nadernik/glass_udrive/BOM/BOM google sheet link.txt

https://docs.google.com/spreadsheets/d/1lBuhaIrTGy6_se6Jq8_9wrTlgxq24nmQ9v349KglLDg/edit?usp=sharing
