nadernik/glass_udrive/BOM/Glass uDrive-BOM.xlsx

Part on PCB | QTY | Value | Device | Package | Description | Use | SUPPLIER | partNo | link
U1 | 1 | AD8224ACPZ-R7 | AD8224 | QFN65P400X400X100-16N | IC OPAMP INSTR 1.5MHZ 16LFCSP-Hidden pad | Wide Supply Range, Rail-to-Rail Output Instrumentation Amplifier | Analog Devices | AD8224HBCPZ-R7CT-ND | https://www.digikey.com/short/jmmmcj
P1 | 1 | A75243-001 | A75243-001 | OMNETICS_A75243-001 |  | 14 pin nano, male | Omnetics | A75243-001
R_BRIDGE | 1 | 100MOhm | R_0402 | 402 | RES 100M OHM 5% 1/16W 0402 | Resistor for bridge balance circuit | Stackpole Electronics Inc | HMC0402JT100MCT-ND | https://www.digikey.com/product-detail/en/stackpole-electronics-inc/HMC0402JT100M/HMC0402JT100MCT-ND/2683714
C_COMP | 1 | 10pF | C_0402 | 402 | CAP CER 10PF 200V C0G/NP0 0402 | Capacitor for capacitance neutralization circuit | American Technical Ceramics | 1284-1096-1-ND | https://www.digikey.com/short/j4081m
C1-C4 | 4 | 6800pF | C_0201 | 201 | CAP CER 6800PF 16V X7R 0201 | Capacitor for high pass filter for electrodes and virtual ground (with R1-R4) | TDK Corporation | 445-12081-1-ND | http://www.digikey.com/short/38852m
C5-C6 | 2 | 0.1uF | C_0201 | 201 | CAP CER 0.1UF 25V X5R 0201 | Bypass capacitor for INA | Samsung Electro-Mechanics | 1276-1318-1-ND | https://www.digikey.com/short/jmmm1h
C7-C8 | 2 | 10uF | R_0603 | 603 | CAP CER 10UF 25V X5R 0603 | Bypass big capacitor for +-15 V supply for INA | Murata Electronics | 490-10991-2-ND | https://www.digikey.com/short/j403zm
R1-R4 | 4 | 10Mohm | R_0201 | 201 | RES SMD 10M OHM 5% 1/20W 0201 | Resistor for high pass filter for electrodes and virtual ground (with C1-C4) | Samsung Electro-Mechanics | 1276-3857-1-ND | https://www.digikey.com/short/jmm95b
R5-R6 | 1 | 5.49KOhm | R_0201 | 201 | RES SMD 5.49K OHM 1/20W 0201 | Gain setting resistor for INA (gain=10) | Panasonic Electronic | P121609CT-ND | https://www.digikey.com/short/j40jpz
SJ1 | 4 | 0 Ohm | R_0201 | 201
