nadernik/glass_udrive/eaglefiles/glass_udrive_pcb.dxf

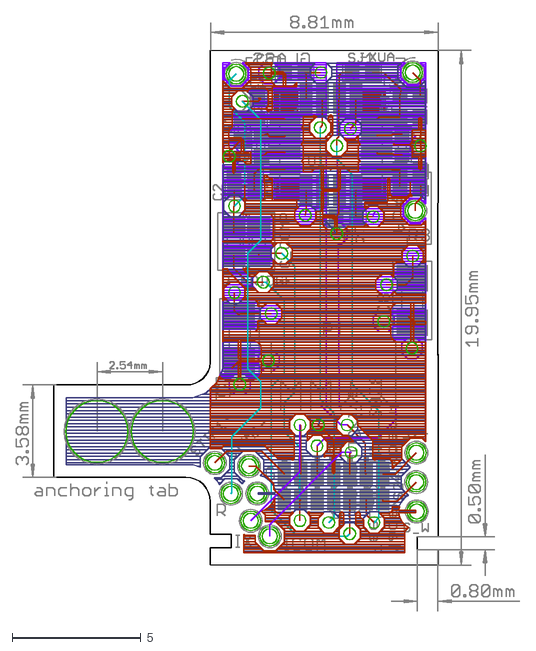
[picture p1: CAD file, 2018-05-21]
eaglefiles/glass_udrive_pcb.dxf
19.5 x 23.1
