nadernik/glass_udrive/layout_files/glass_udrive_pcb.dxf

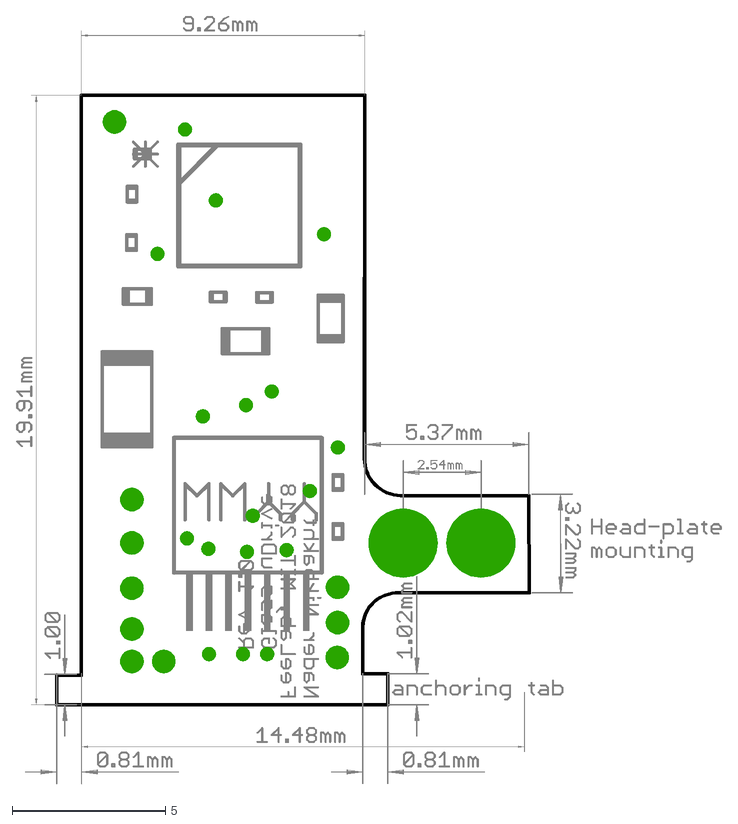
[picture p2: CAD file, 2018-05-07]
layout_files/glass_udrive_pcb.dxf
23.0 x 25.1
