nadernik/glass_udrive/eaglefiles/glass_udrive_pcb.brd

## EAGLE design eaglefiles/glass_udrive_pcb.brd (2018-05-24)

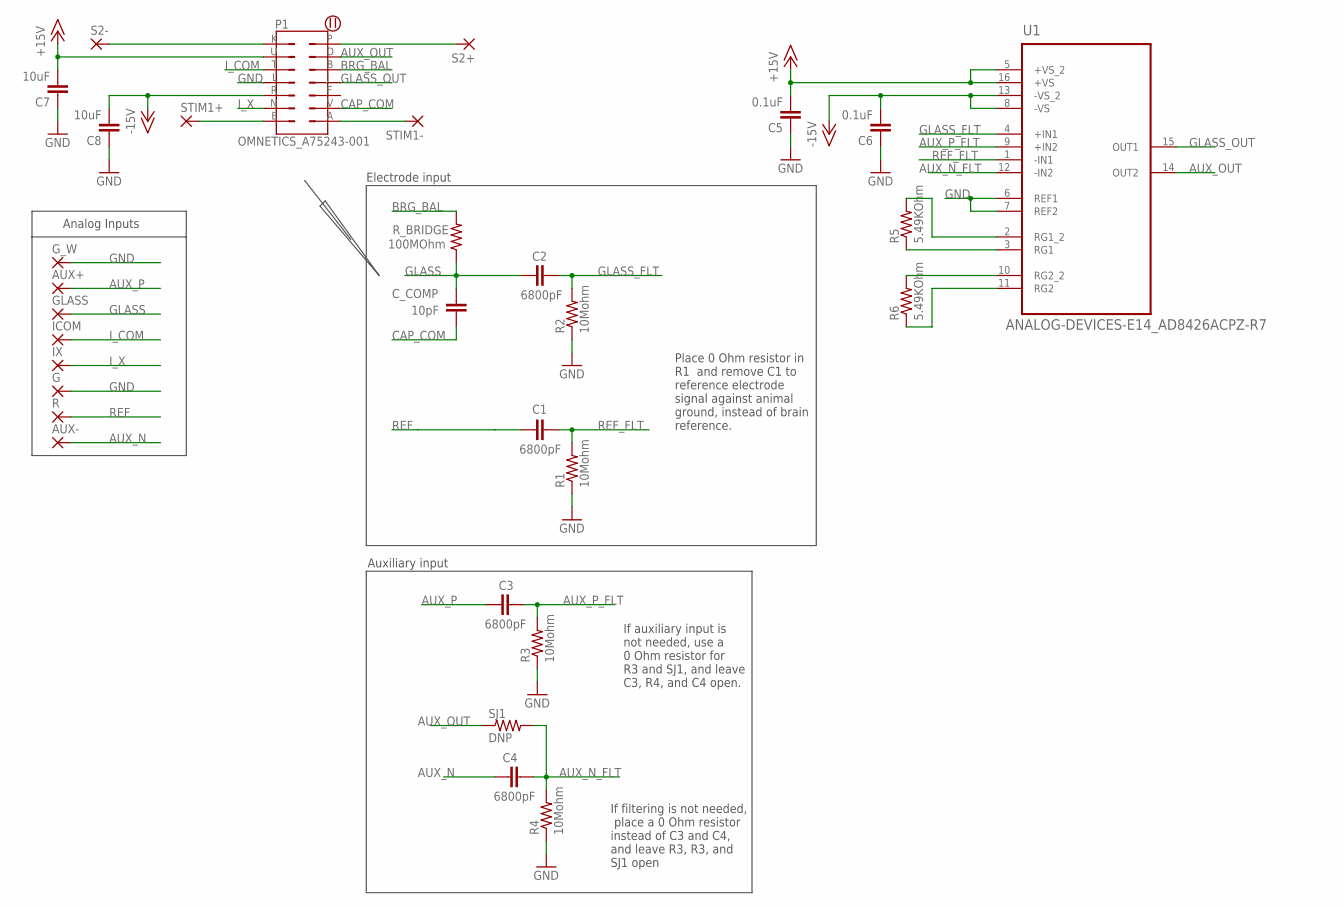
[picture p3: schematic glass_udrive_pcb.sch]

Parts:
AUX+: THROUGH-HOLE-30MIL/15MIL; 30MIL/15MIL
AUX-: THROUGH-HOLE-30MIL/15MIL; 30MIL/15MIL
C1, C2, C3, C4: 6800pF; 0201
C5, C6: 0.1uF; 0201
C7, C8: 10uF; 0603
C_COMP: 10pF; 0402
G: THROUGH-HOLE-30MIL/15MIL; 30MIL/15MIL
GLASS: THROUGH-HOLE-30MIL/15MIL; 30MIL/15MIL
G_W: THROUGH-HOLE-30MIL/15MIL; 30MIL/15MIL
ICOM: THROUGH-HOLE-30MIL/15MIL; 30MIL/15MIL
IX: THROUGH-HOLE-30MIL/15MIL; 30MIL/15MIL
P1: OMNETICS_A75243-001
R: THROUGH-HOLE-30MIL/15MIL; 30MIL/15MIL
R1, R2, R3, R4: 10Mohm; 0201
R5, R6: 5.49KOhm; 0201
R_BRIDGE: 100MOhm; 0402
S2+, S2-: THROUGH-HOLE-30MIL/15MIL; 30MIL/15MIL
SJ1: DNP; 0201
STIM1+, STIM1-: THROUGH-HOLE-30MIL/15MIL; 30MIL/15MIL
U1: ANALOG-DEVICES-E14_AD8426ACPZ-R7; ANALOG-DEVICES-E14_QFN65P400X400X100-16N

Connections:
+15V: C5.2, C7.2, P1.U, U1.5 (+VS_2), U1.16 (+VS)
-15V: C6.2, C8.2, P1.R, U1.8 (-VS), U1.13 (-VS_2)
AUX_N: AUX-.P$1, C4.1
AUX_N_FLT: C4.2, R4.2, SJ1.2, U1.12 (-IN2)
AUX_OUT: P1.D, SJ1.1, U1.14 (OUT2)
AUX_P: AUX+.P$1, C3.1
AUX_P_FLT: C3.2, R3.2, U1.9 (+IN2)
BRG_BAL: P1.B, R_BRIDGE.2
CAP_COM: C_COMP.2, P1.V
GLASS: C2.1, C_COMP.1, GLASS.P$1, R_BRIDGE.1
GLASS_FLT: C2.2, R2.2, U1.4 (+IN1)
GLASS_OUT: P1.J, U1.15 (OUT1)
GND: C5.1, C6.1, C7.1, C8.1, G.P$1, G_W.P$1, P1.L, R1.1, R2.1, R3.1, R4.1, U1.6 (REF1), U1.7 (REF2)
I_COM: ICOM.P$1, P1.T
I_X: IX.P$1, P1.N
unnamed: R5.2, U1.2 (RG1_2)
unnamed: R5.1, U1.3 (RG1)
unnamed: R6.2, U1.10 (RG2_2)
unnamed: R6.1, U1.11 (RG2)
REF: C1.1, R.P$1
REF_FLT: C1.2, R1.2, U1.1 (-IN1)
STIM1_N: P1.A, STIM1-.P$1
STIM1_P: P1.E, STIM1+.P$1
STIM2_N: P1.P, S2+.P$1
STIM2_P: P1.K, S2-.P$1

Notes on the sheet:
Analog Inputs
Electrode input
Auxiliary input
Place 0 Ohm resistor in R1 and remove C1 to reference electrode signal against animal ground, instead of brain reference.
If auxiliary input is not needed, use a 0 Ohm resistor for R3 and SJ1, and leave C3, R4, and C4 open.
If filtering is not needed, place a 0 Ohm resistor instead of C3 and C4, and leave R3, R3, and SJ1 open

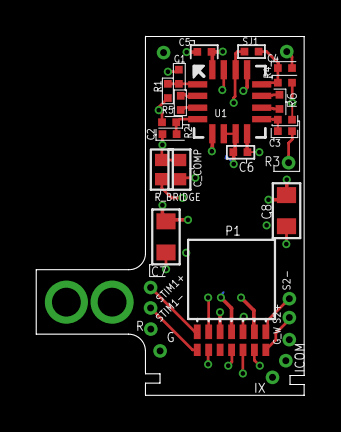
[picture p4: board glass_udrive_pcb.brd from above]

Board: 4 copper layers, 14.9 x 19.9 mm, 31 parts (0 on the bottom side), 25 nets.
