nadernik/glass_udrive/(commit log)

2018-04-24 :original commit adding PCB design files
    [glass_udrive_pcb.brd, glass_udrive_pcb.sch]
2018-04-24 smashed labels
    [glass_udrive_pcb.brd, glass_udrive_pcb.sch]
2018-04-25 Galen's suggested changes to Rev 1.0
    I have changed a number of things in your design, one of which is major and the
    rest are minor. The major change is that I have added a guard trace to your
    design, in accordance with the data sheet for the OPA129. If you are going to
    use an ultra-low input bias current op amp, then you should make efforts to
    actually achieve the performance that it touts. The other changes are mostly
    positioning to accommodate the guard trace, changes to the silk screen on your
    board, and simplification of the routing of some traces.
    To achieve very low input bias, you need to make sure that there is no leakage
    current to the electrode net from the rest of the PCB. There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
    [glass_udrive_pcb.brd, glass_udrive_pcb.sch]
2018-04-25 3D snapshots and Galen's edits merged.
    [glass_udrive_pcb.brd]
2018-04-30 added data sheets for AD8224
    [glass_udrive_pcb.brd]
2018-05-03 Revision AD8224 redesigned to use instrumentation amplifier with a reference electrode. This version has 2 input and 2 INA output channels one for glass electrode and another for a metal electrode.
    [BOM.xlsx, glass_udrive_pcb.brd, glass_udrive_pcb.sch]
2018-05-03 the modified version w/o output channel 2 and metal electrode input.
    [glass_udrive_pcb.brd, glass_udrive_pcb.sch]
2018-05-07 1-Incorporating Michael Stetner's comments: ====================================================== 1. Move vias carrying output signals away from the corners of the AD8224. According to the datasheet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
    [BOM.xlsx, glass_udrive_pcb.brd, glass_udrive_pcb.sch]
2018-05-07 extended drive length to give more space at the bottom for dental cement anchoring. PCB = 9.26mm X 19.91 mm
    [glass_udrive_pcb.brd]
2018-05-07 solved the order of CAPCOM and Bridge balance nets and routing as per GFL suggestions.
    [glass_udrive_pcb.brd, glass_udrive_pcb.sch]
2018-05-07 minor routing and dimension and docu layer changes.
    [glass_udrive_pcb.brd, glass_udrive_pcb.dxf]
2018-05-08 Move eagle design files into separate directory
    [glass_udrive_pcb.brd, glass_udrive_pcb.sch]
2018-05-08 Add gerbers dir to project, which should be empty
2018-05-08 Move layouyt files to their own directory
    [glass_udrive_pcb.dxf]
2018-05-08 Remove screenshots from repo
    These screen shots are 'derived' from the design files and should not be in the
    repository itself. For example, are they currently up to date, or do they
    reflect the design as it was a few commits ago? It's hard to tell, and therefore
    I think these sorts of files do more harm than good.
2018-05-09 Dev branches merged into master branch. Optimizing the board routing and incorporating GFL comments: =========================== 1- top right of AD8224 (pins 12 and 13): don't run a trace under the c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
    [glass_udrive_pcb.brd]
2018-05-10 updated several board layout details: made it smaller H and W, changed the anchoring tab on the opposite side, added +-15 power supply pours to simplify routing and reduced bridge resistor size to 40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
    [BOM.xlsx, glass_udrive_pcb.brd, glass_udrive_pcb.sch]
2018-05-11 Move bridge balance resistor up and trace from glass electrode to CAPCOM to layer 15
    [glass_udrive_pcb.brd]
2018-05-11 Added optional circuit for 2nd INA channel and routing optimized.
    [BOM.xlsx, glass_udrive_pcb.brd, glass_udrive_pcb.sch]
2018-05-13 simple routing finish-up and silk-screen stuff.
    [glass_udrive_pcb.brd]
2018-05-13 Went very OCD on your design
    Made the power planes bigger because they had no reason not to be.
    Renamed some nets because I found them confusing when looking at your schematic.
    Moved stuff for cleaner routing.
    Added a top ground plane to prevent stray capacitance onto any moving wires for
    your electrode etc.
    Improved via placement on bypass capacitors.
    Re-organized schematic to some degree.
    Renamed components to have more standard designator names, e.g. P1 instead of
    'omnetics' and U1 instead of "AD82**"
    Moved vias around to not make big breaks in the ground plane.
    Messed with dimensions so they're all rectilinear and meet up with eachother.
    [glass_udrive_pcb.brd, glass_udrive_pcb.sch]
2018-05-14 Made glass net more compact.
    Silk screen needs a lot of work
    [glass_udrive_pcb.brd, glass_udrive_pcb.sch]
2018-05-14 improvements on slikscreen and component naming and placing.
    [glass_udrive_pcb.brd, glass_udrive_pcb.sch]
2018-05-14 final touch by NN.
    [glass_udrive_pcb.brd]
2018-05-21 minor routing and dimention and docu layer improvements.
    [BOM.xlsx, glass_udrive_pcb.brd, glass_udrive_pcb.dxf]
2018-05-23 gerber files generated.
    [Glass uDrive-BOM.xlsx, glass_udrive_pcb.brd]
2018-05-24 minor edits to board layout, moved vias from under the motor, increased trace width to 6mil and above. GALEN CHECKED after Stetner checked!
    [glass_udrive_pcb.brd]
